wagiminator/ATtiny13-TinyPocketRadio/hardware/TinyPocketRadio_schematic.pdf

# VCC PB⁵

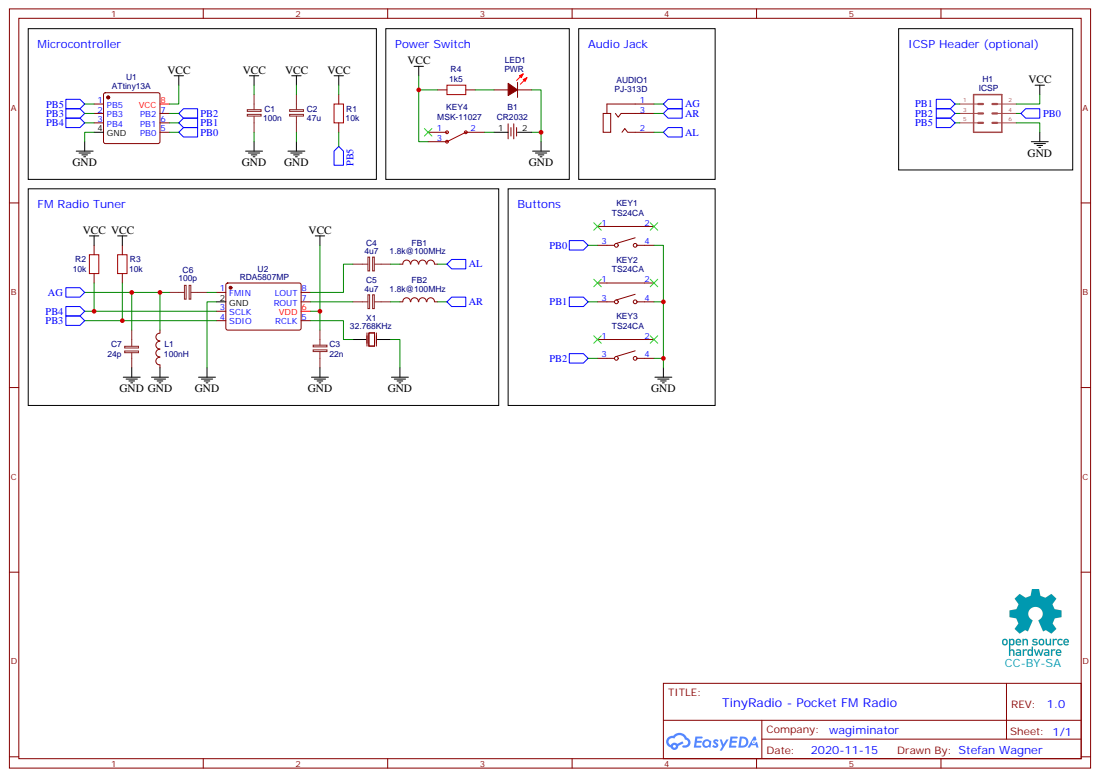
[picture p5: page 1]

Drawn By: Stefan Wagner
