wagiminator/ATtiny13-TinyPocketRadio/(threads)

Thread 1 (2021-02-21):

Coin cell battery is lithium or regular?

hardwork-machines, 2021-02-21:

hardwork-machines, 2021-02-21:
I'm also not seeing oscillator on the board.
does rda5807mp has inbuilt oscillator?

wagiminator, 2021-02-21:
It's for 3V non-rechargeable lithium batteries. Do not use batteries with a voltage of above 3.5V !

Closed 2021-02-21.
